unkyulee/boombox/images/001.JPG

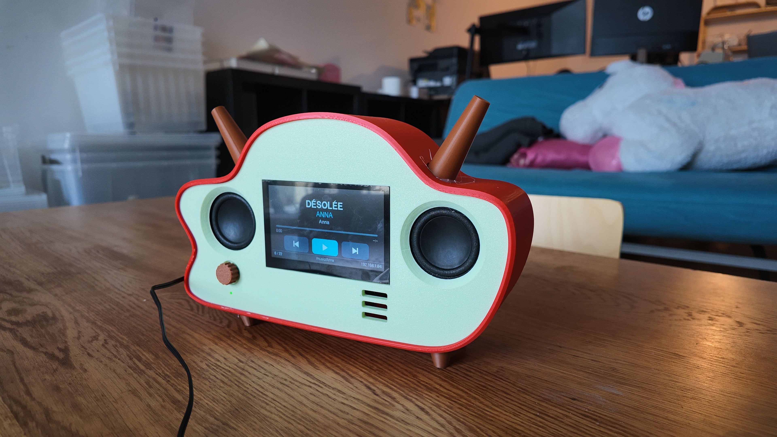
images/001.JPG
