unkyulee/boombox/images/002.png

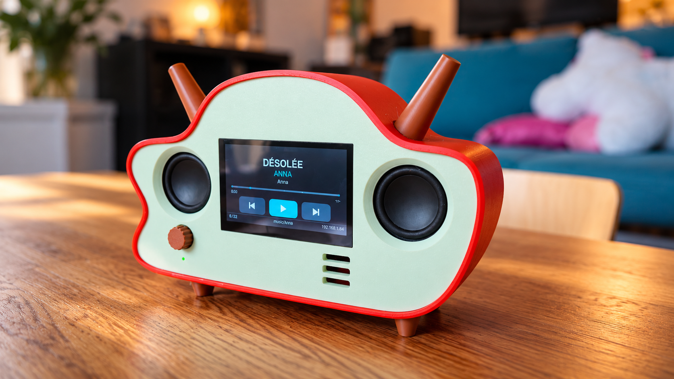
images/002.png
