unkyulee/boombox/images/003.JPG

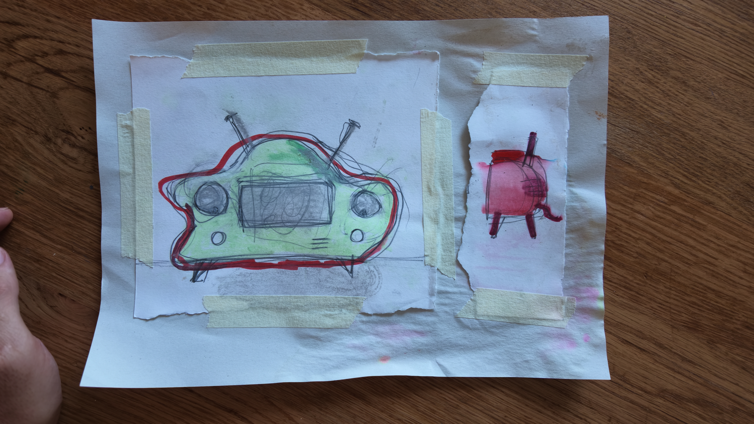
images/003.JPG
