unkyulee/boombox/images/006.JPG

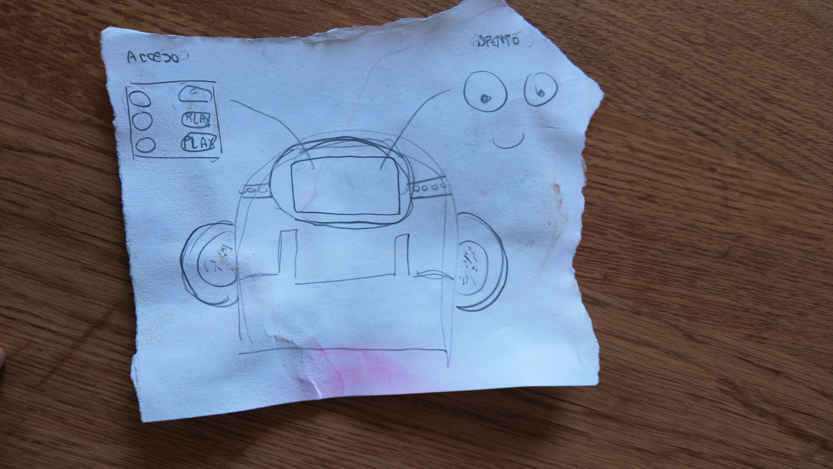
images/006.JPG
