unkyulee/boombox/images/006.png

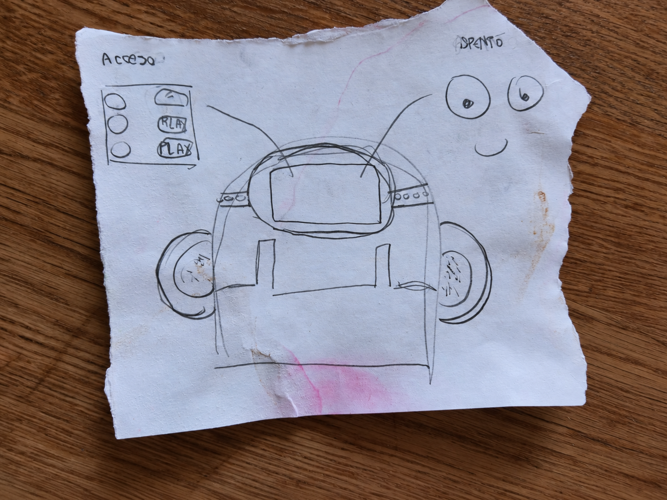
images/006.png
