unkyulee/boombox/images/007.JPG

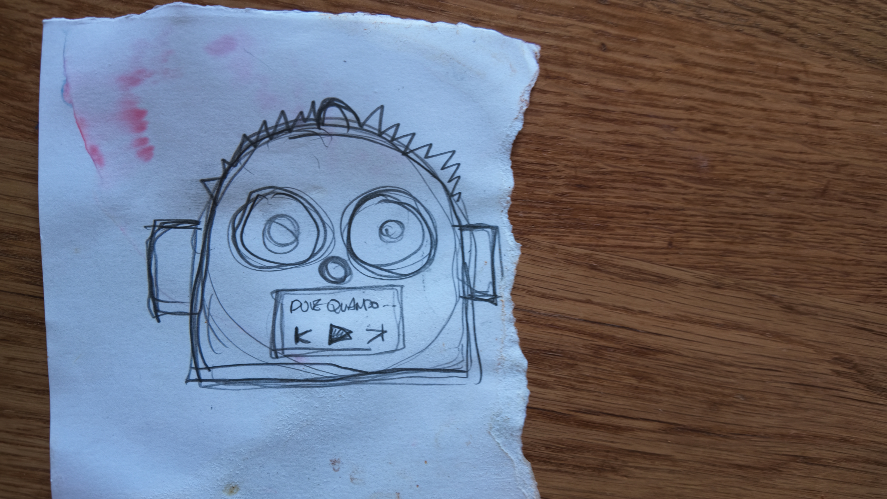
images/007.JPG
