unkyulee/boombox/images/008.png

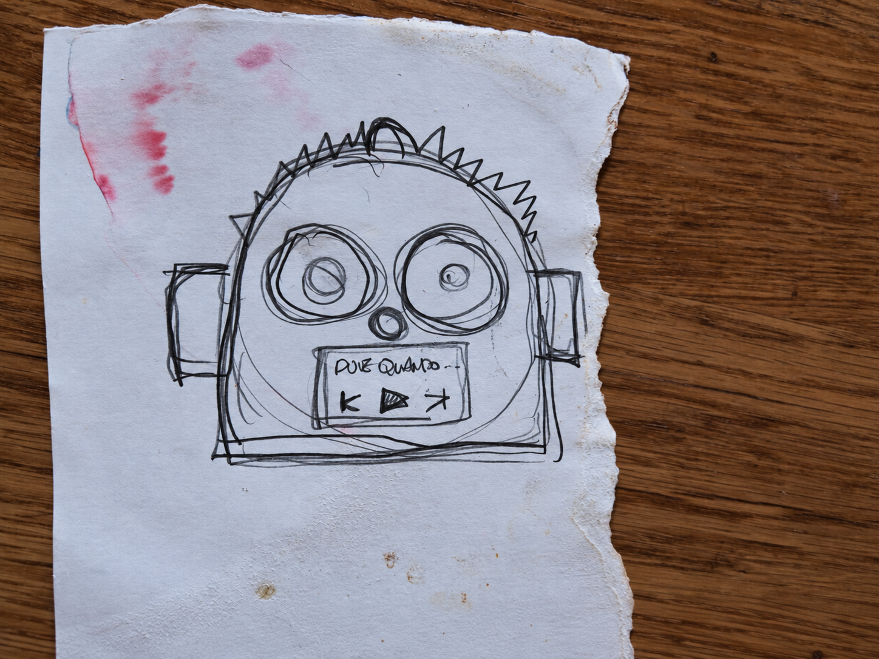
images/008.png
