unkyulee/boombox/images/009.png

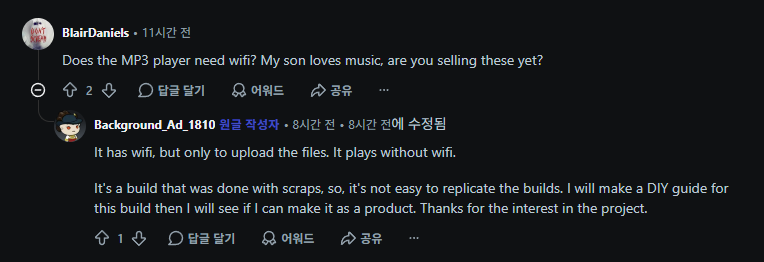
images/009.png
