unkyulee/boombox/STL/Leg.stl

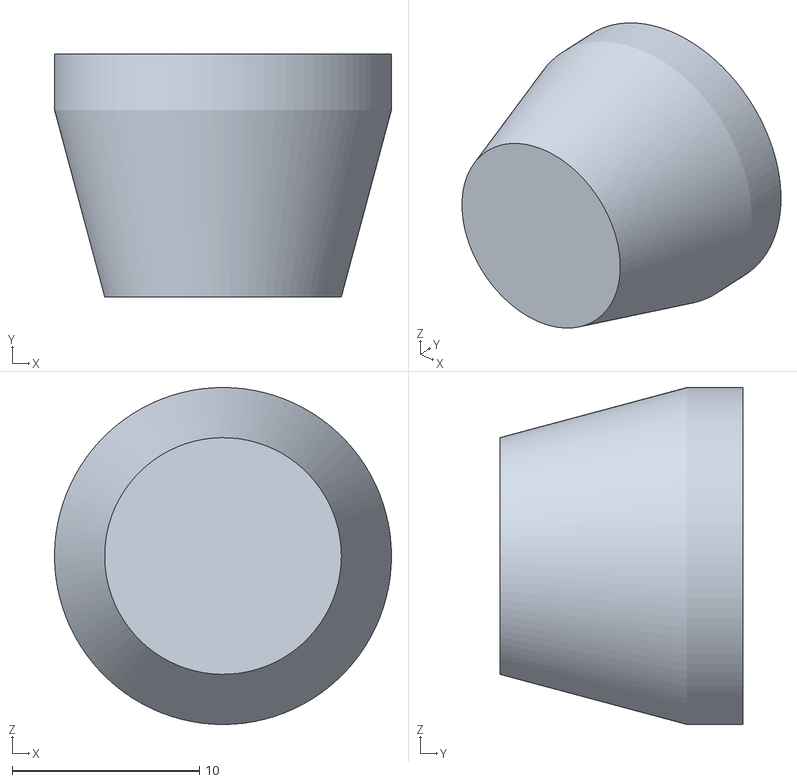
[picture p14: CAD file, 2026-11-01]
STL/Leg.stl
18.0 x 13.0 x 18.0
