unkyulee/boombox/STL/Antenna.stl

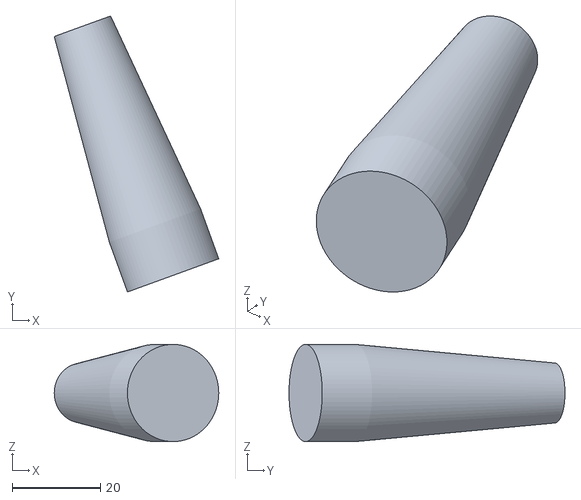
[picture p15: CAD file, 2026-11-01]
STL/Antenna.stl
37.2 x 62.5 x 22.0
