unkyulee/boombox/STL/mp3-player.3mf

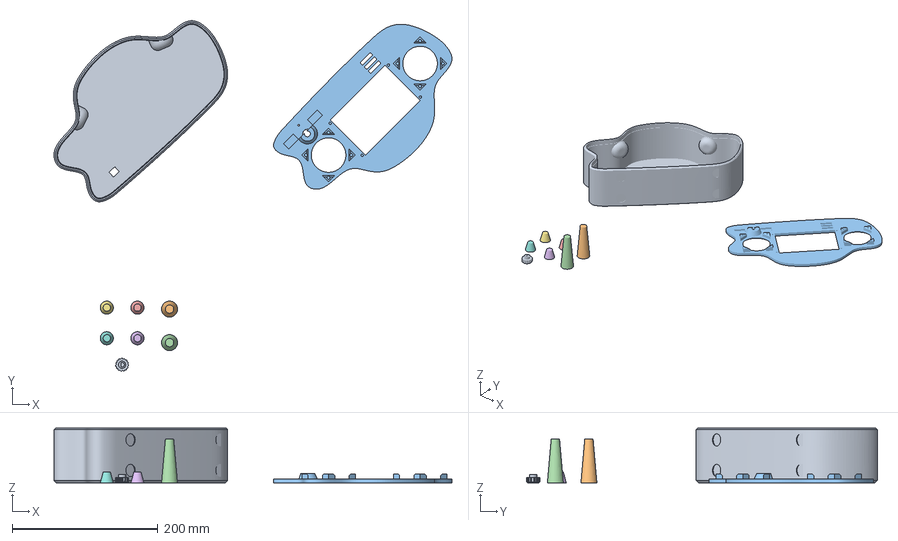
[picture p16: CAD file, 2026-11-01]
STL/mp3-player.3mf
545.7 x 480.8 x 75.0 mm
Enclosure.stl
Antenna.stl x 2
Display.stl
Leg.stl x 4
Knob.stl
