unkyulee/boombox/STL/Display.stl

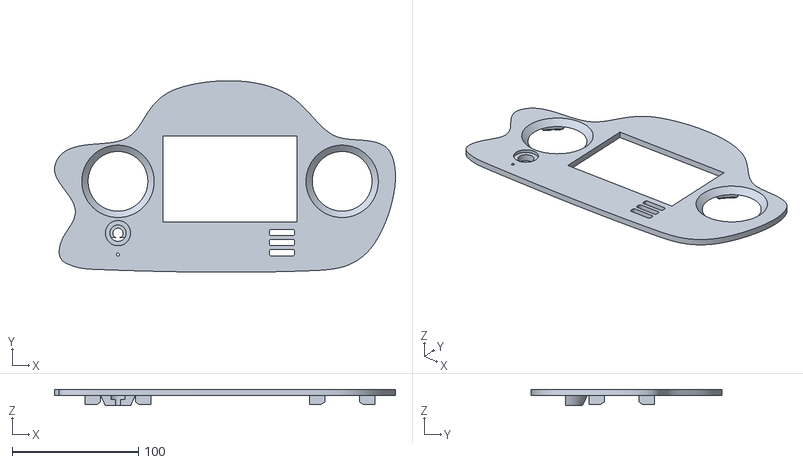
[picture p17: CAD file, 2026-11-01]
STL/Display.stl
270.0 x 151.6 x 13.0
