unkyulee/boombox/STL/Enclosure.stl

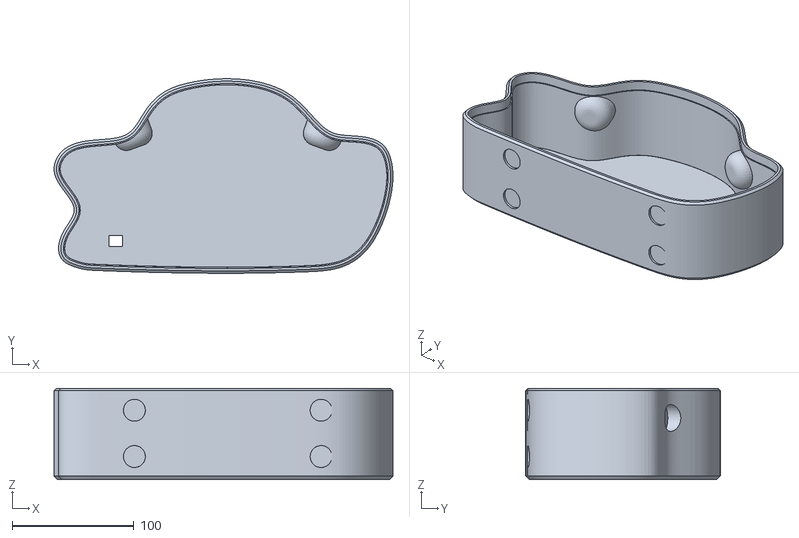
[picture p18: CAD file, 2026-11-01]
STL/Enclosure.stl
278.0 x 159.6 x 75.0
