unkyulee/boombox/STL/Knob.stl

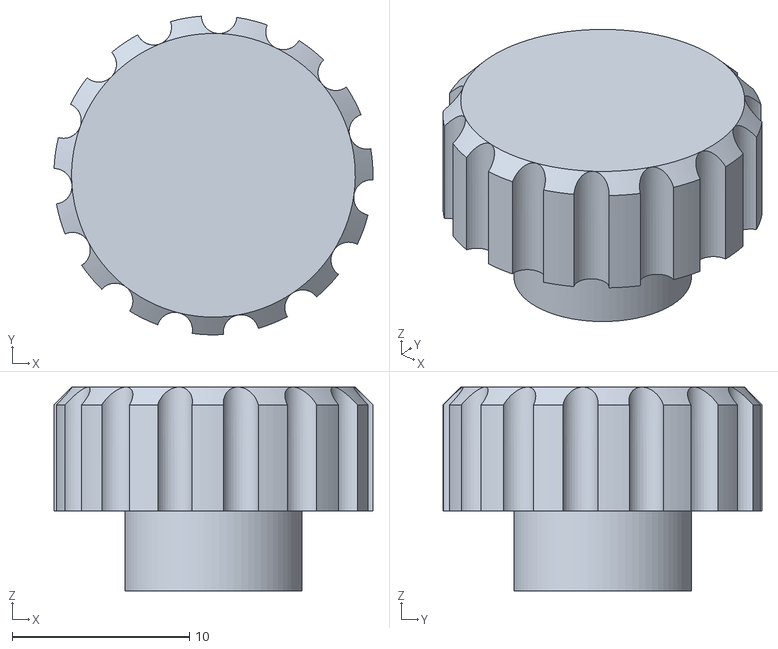
[picture p19: CAD file, 2026-11-01]
STL/Knob.stl
18.0 x 18.0 x 11.5
