unkyulee/boombox/(list of files, cad)

Other CAD files:
STL/MusicPlayer.f3d
