unkyulee/boombox/(commit log)

2025-07-17 mouse knob QMK code
    [Display Holder.stl, Display Plate Left.stl, Display Plate Middle.stl, Display Plate Right.stl, Eclosure Middle 1.stl, Enclosure Left.stl, Enclosure Middle.stl, Enclosure Right.stl]
2026-11-01 mp3 player for my daughter
    [Antenna.stl, Display Holder.stl, Display Plate Left.stl, Display Plate Middle.stl, Display Plate Right.stl, Display.stl, Eclosure Middle 1.stl, Enclosure Left.stl]
